Santocoyo/Estacion-de-radiacion-solar/Images/fototransistor soldado.jpg

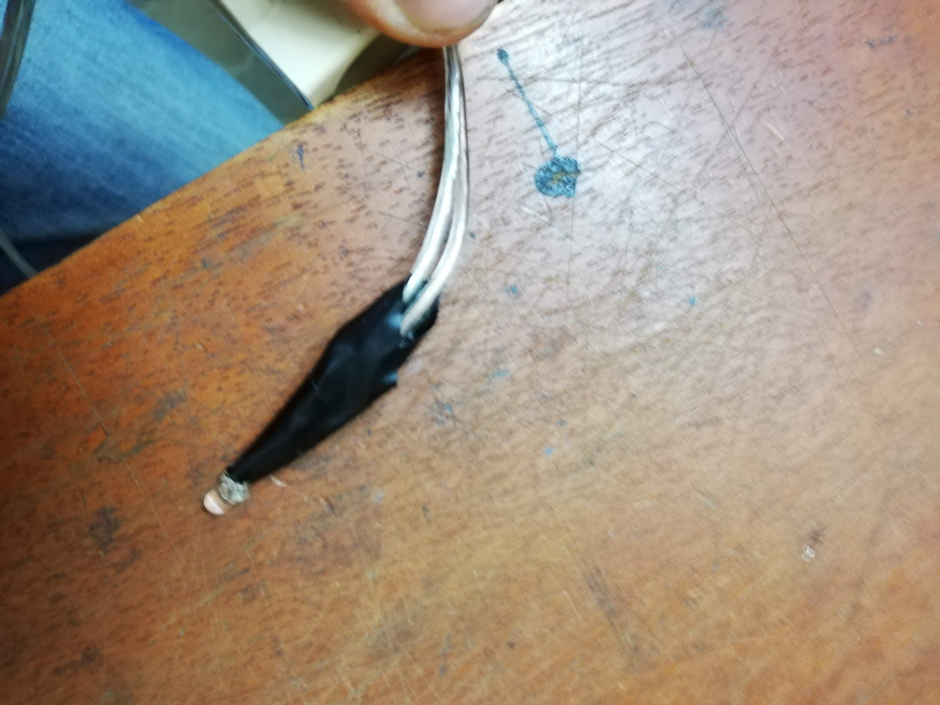
Images/fototransistor soldado.jpg
