Santocoyo/Estacion-de-radiacion-solar/Images/base con fototransistor.jpg

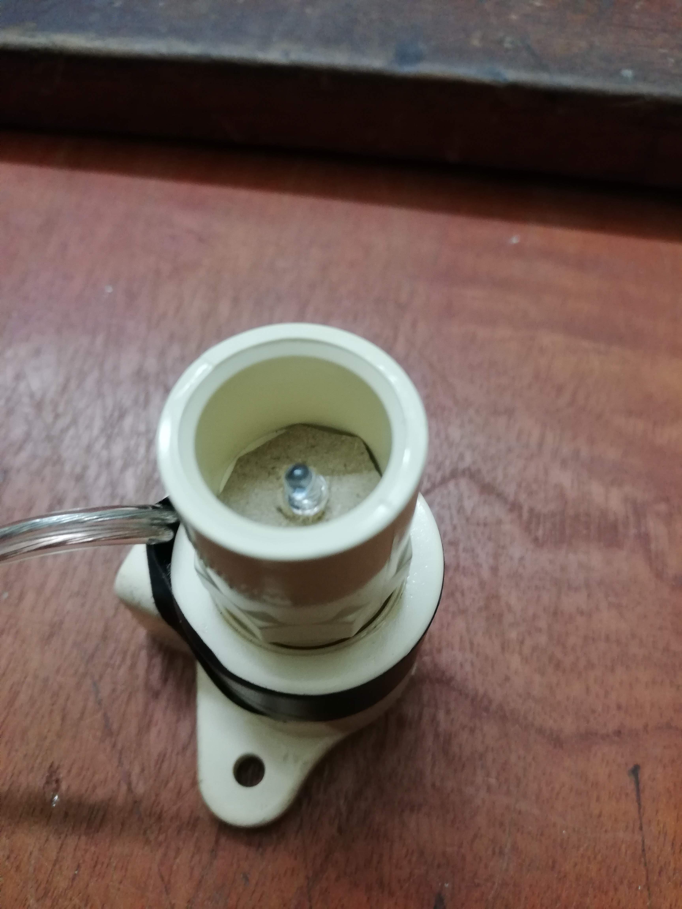
Images/base con fototransistor.jpg
