Santocoyo/Estacion-de-radiacion-solar/Images/base con teflon.jpeg

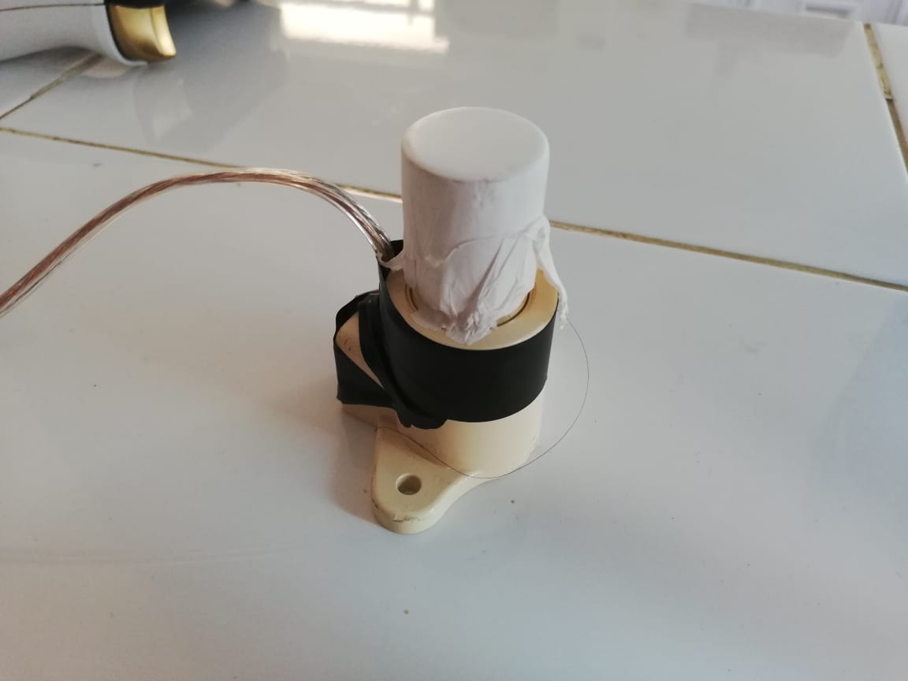
Images/base con teflon.jpeg
