Santocoyo/Estacion-de-radiacion-solar/Images/base en panel.jpg

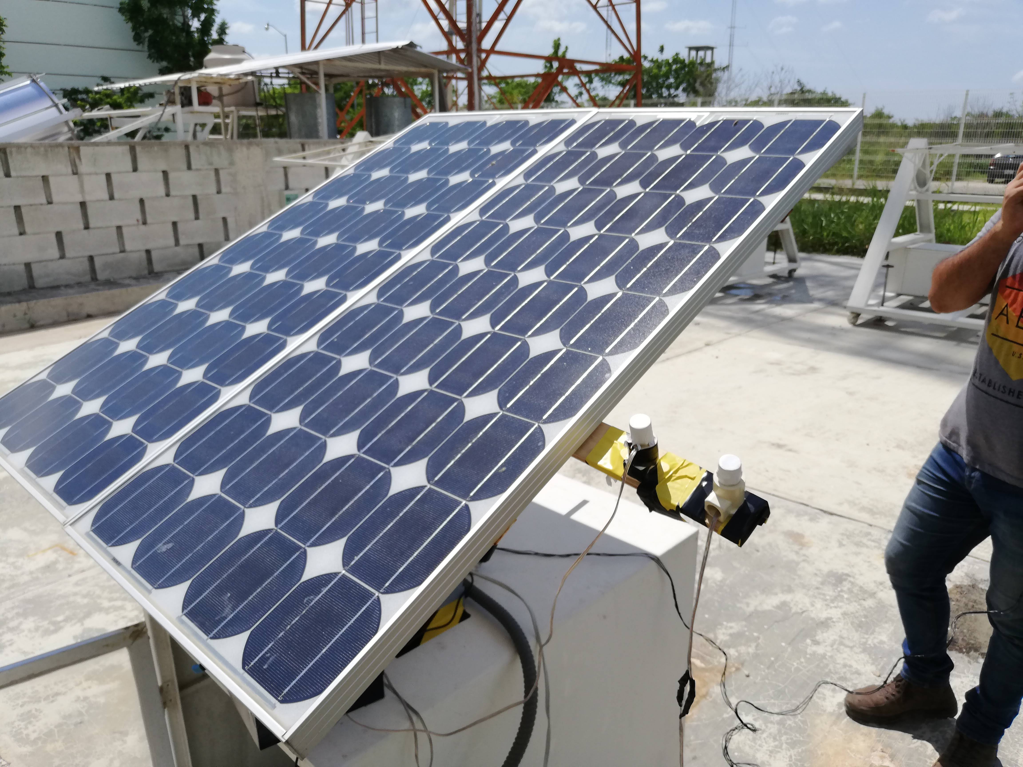
Images/base en panel.jpg
