Santocoyo/Estacion-de-radiacion-solar/Images/cargador.jpg

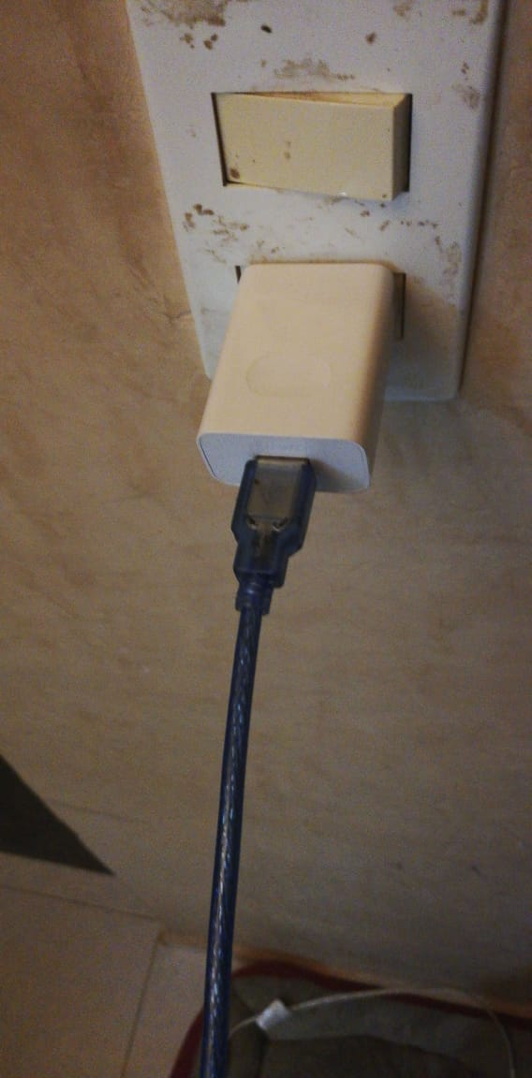
Images/cargador.jpg
