Santocoyo/Estacion-de-radiacion-solar/Images/circuito caja.jpg

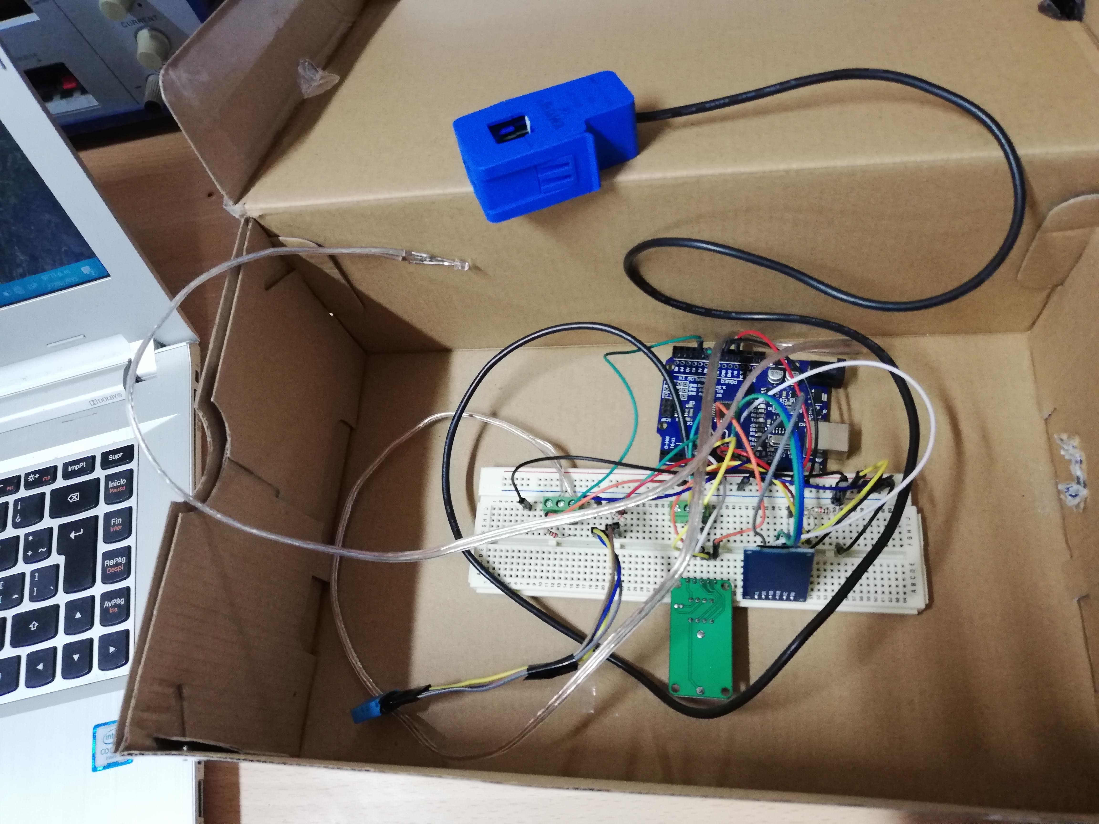
Images/circuito caja.jpg
