Santocoyo/Estacion-de-radiacion-solar/Images/Conexión.jpeg

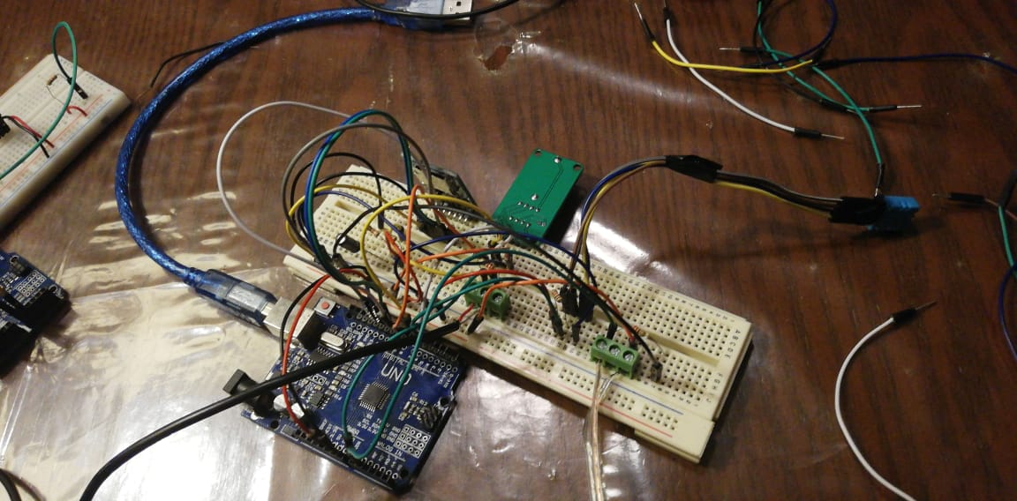
Images/Conexión.jpeg
