Santocoyo/Estacion-de-radiacion-solar/Images/Corriente_y_radiación.png

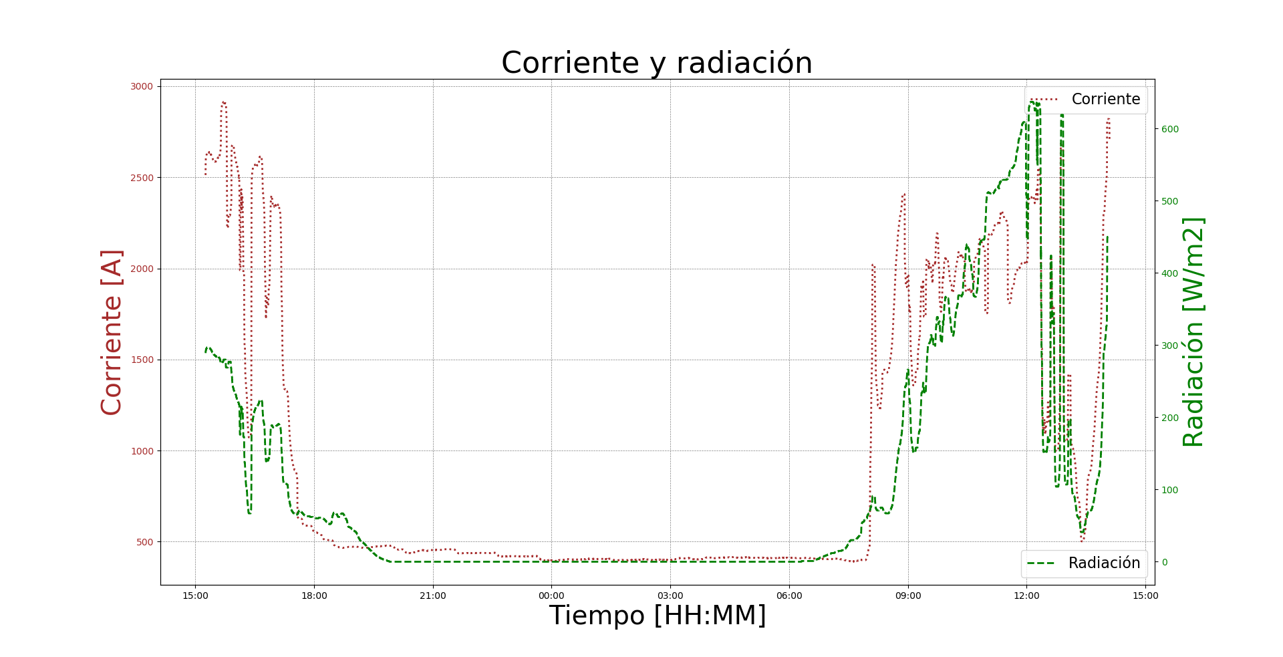
Images/Corriente_y_radiación.png
