Santocoyo/Estacion-de-radiacion-solar/Images/Estacion de radiacion_bb.png

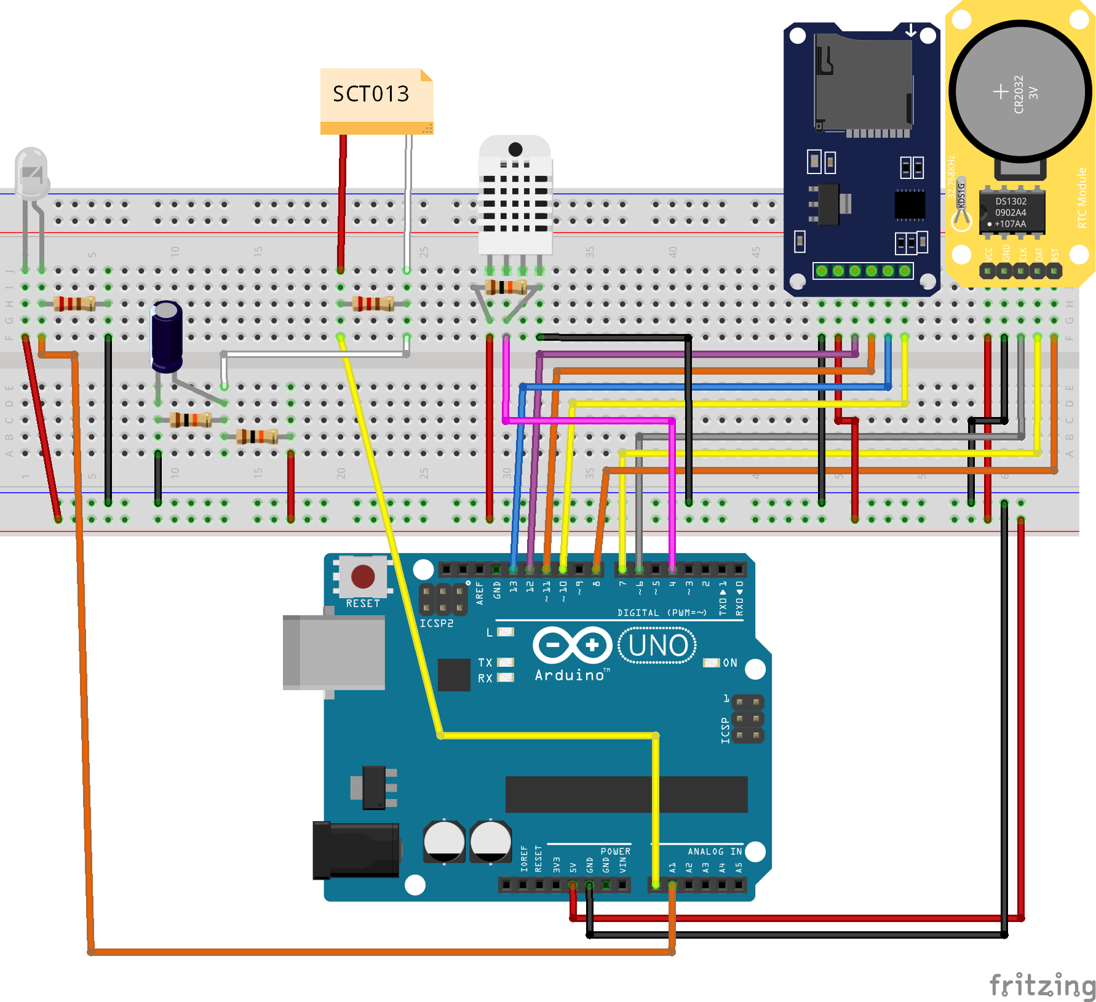
Images/Estacion de radiacion_bb.png
