Santocoyo/Estacion-de-radiacion-solar/Images/sct013.jpg

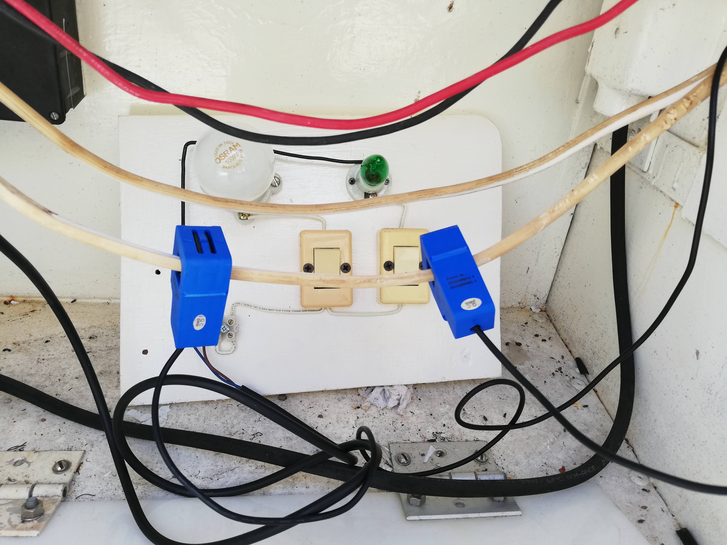
Images/sct013.jpg
