Santocoyo/Estacion-de-radiacion-solar/Images/Temperatura_y_humedad.png

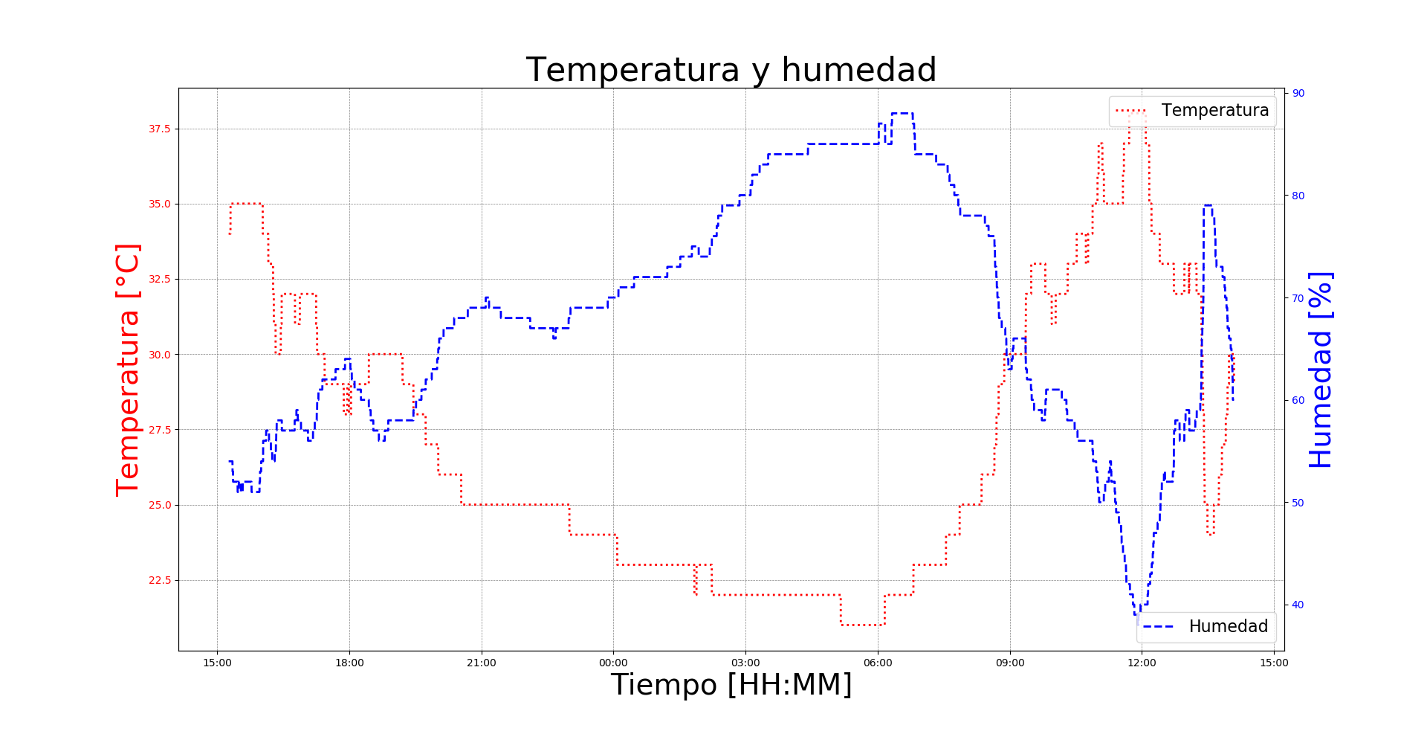
Images/Temperatura_y_humedad.png
