Santocoyo/Estacion-de-radiacion-solar/(list of files, drawings)

Other design files:
Schemes/Estacion de radiacion.fzz
